wolfson292/pool_controller_v2/README.md

# pool_controller_v2
ESPHome Based Pool &amp; Spa Automation Controller
