wolfson292/pool_controller_v2/Pool-Spa-Controller-V2.kicad_pcb

## KiCad design Pool-Spa-Controller-V2.kicad_pcb (2025-02-10)

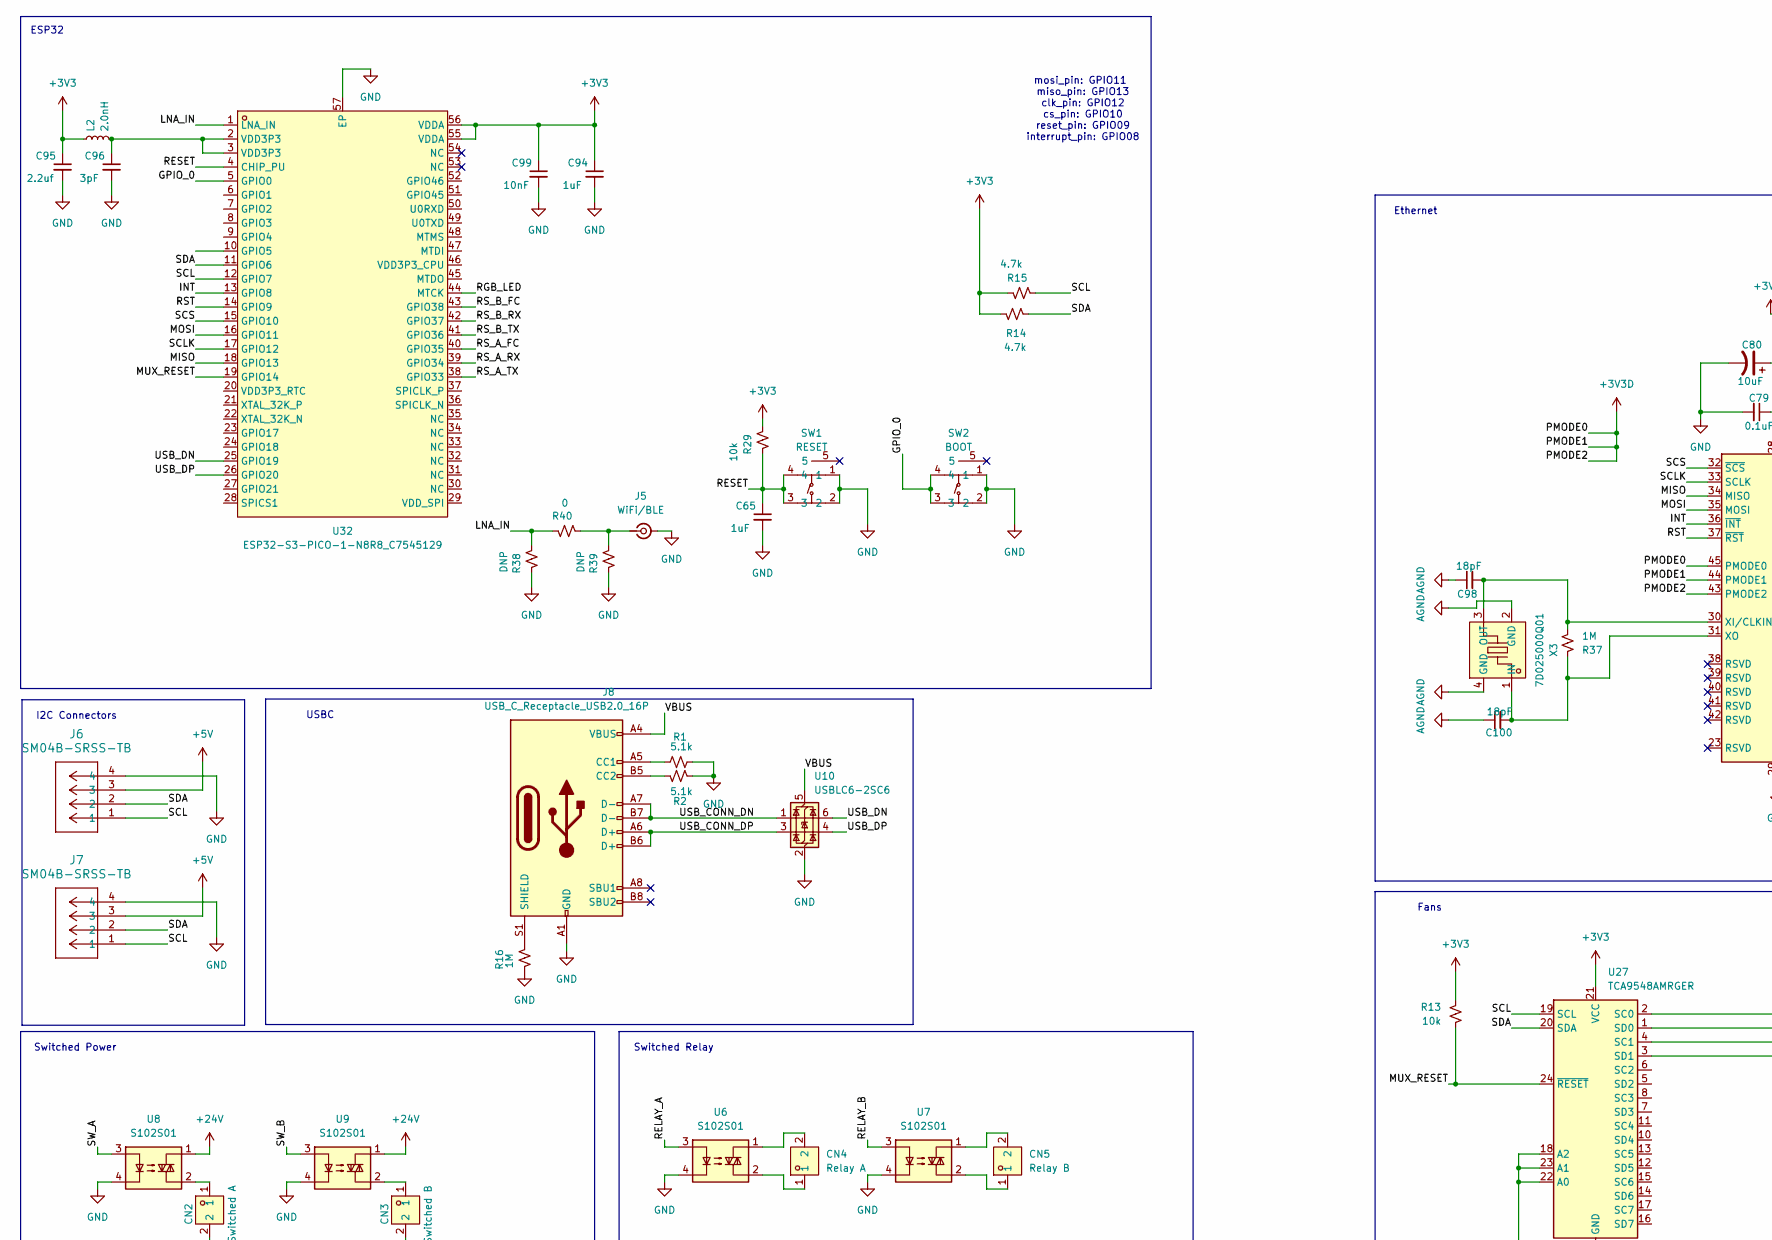
[picture p1: schematic Pool-Spa-Controller-V2.kicad_sch, part in row 1, column 1]

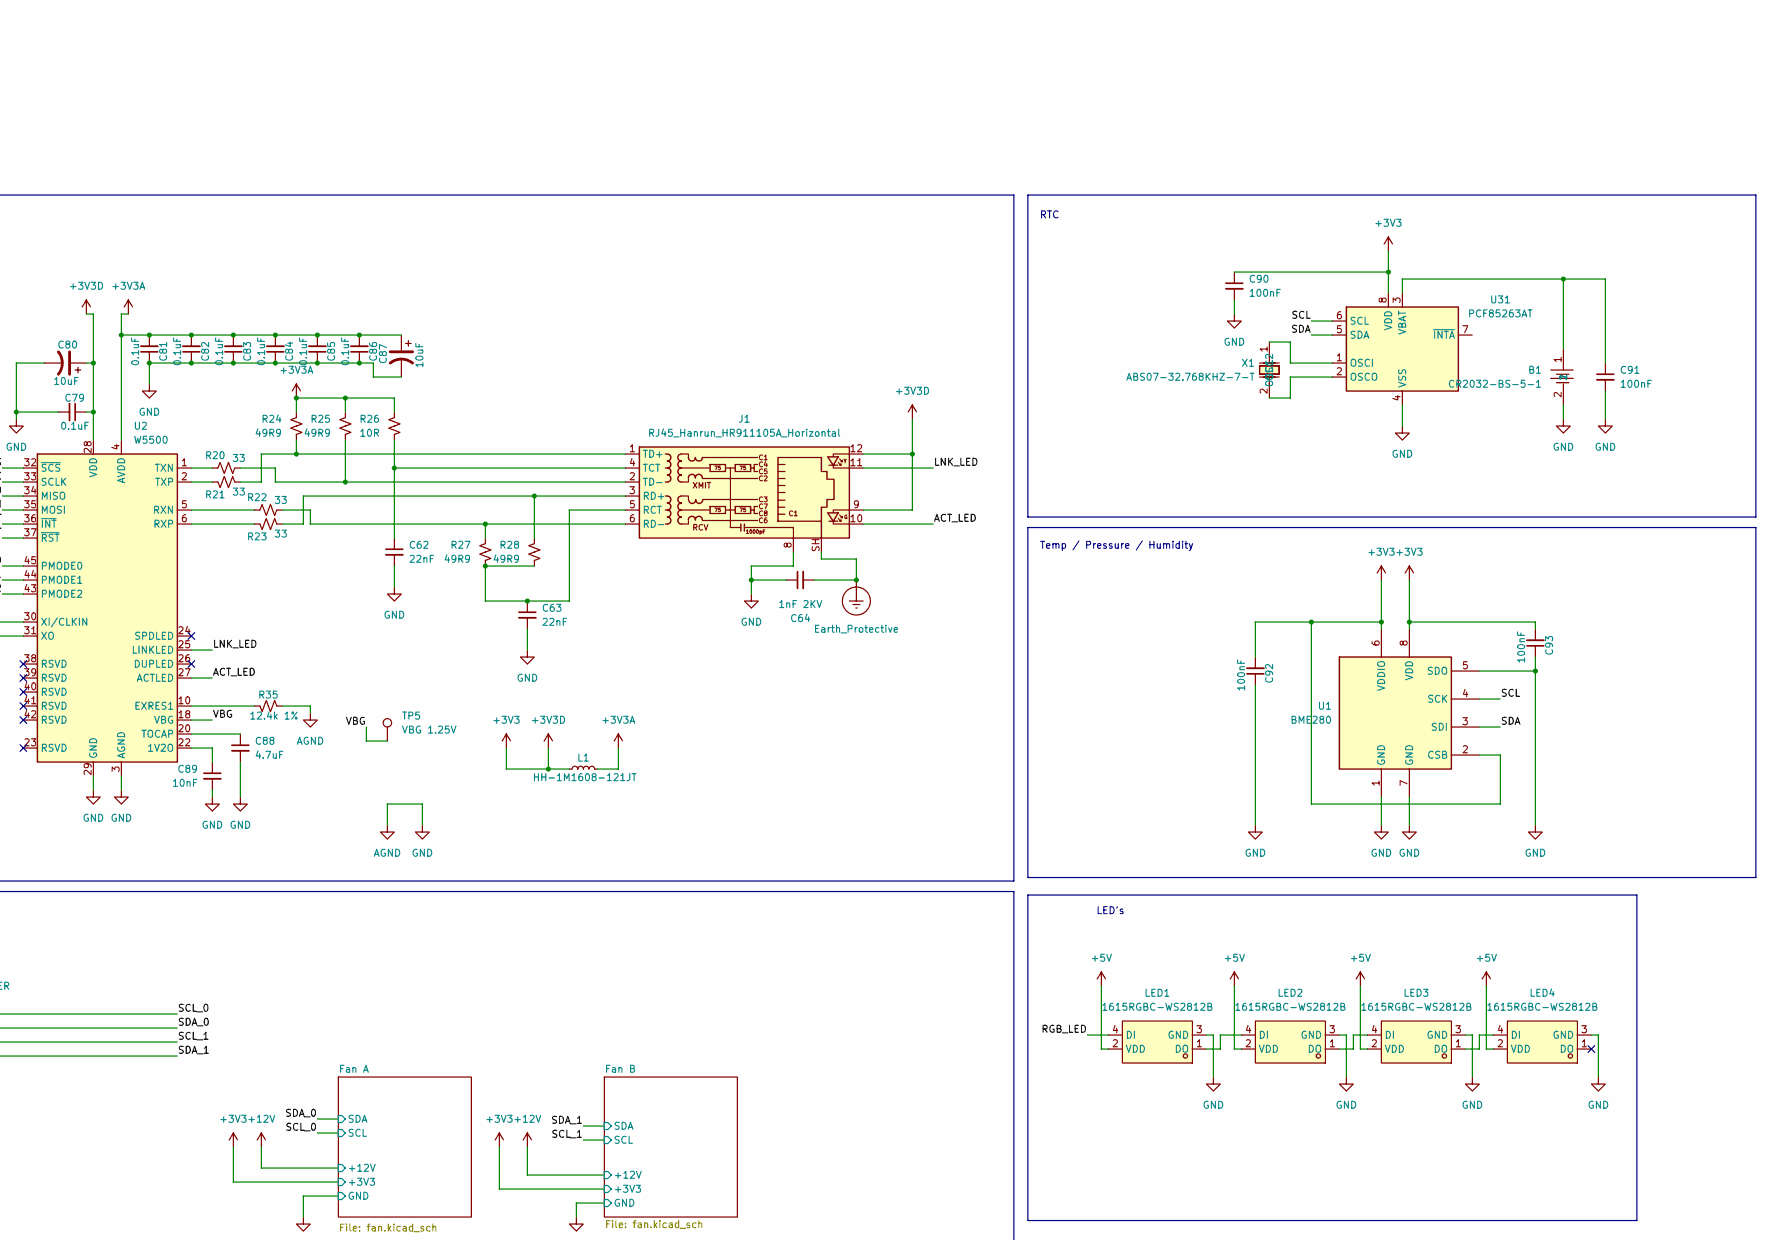
[picture p2: schematic Pool-Spa-Controller-V2.kicad_sch, part in row 1, column 2]

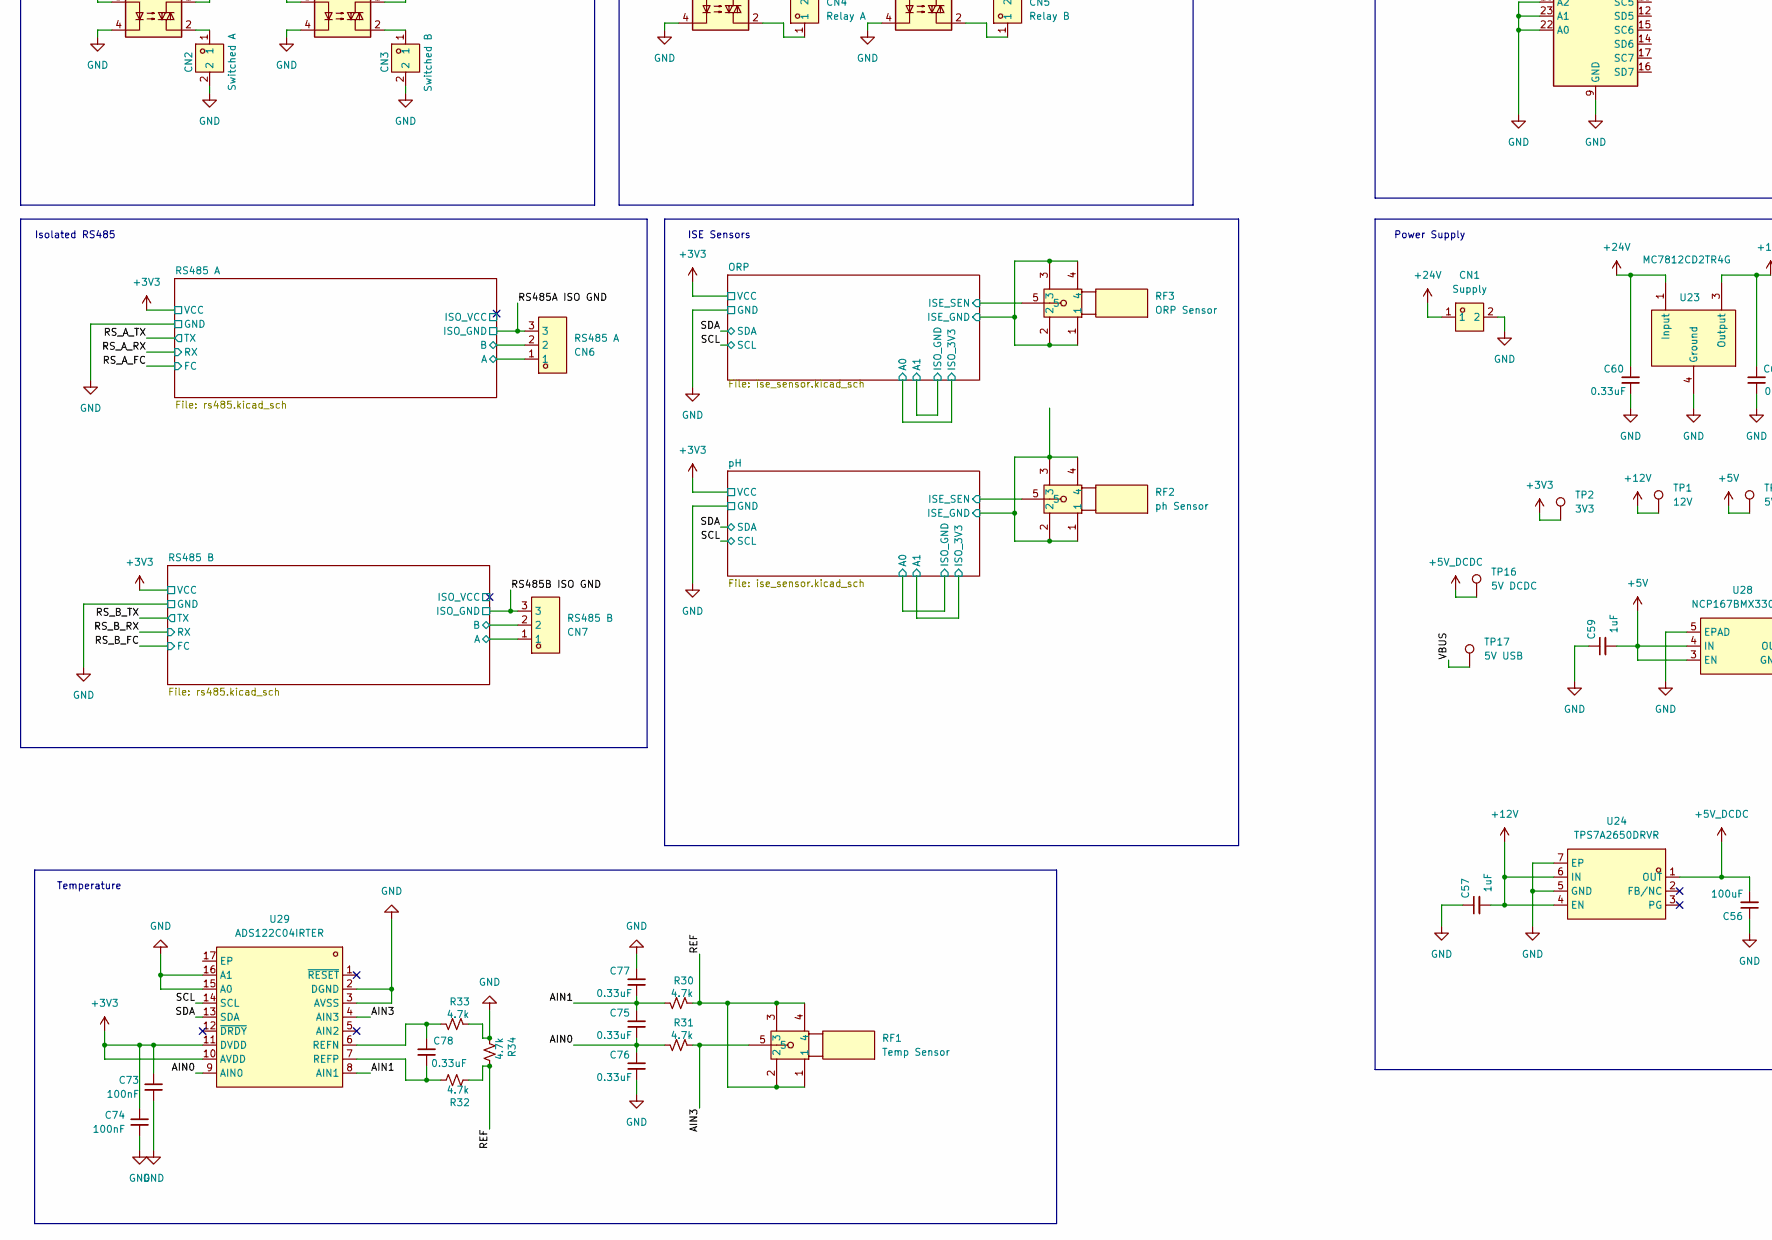
[picture p3: schematic Pool-Spa-Controller-V2.kicad_sch, part in row 2, column 1]

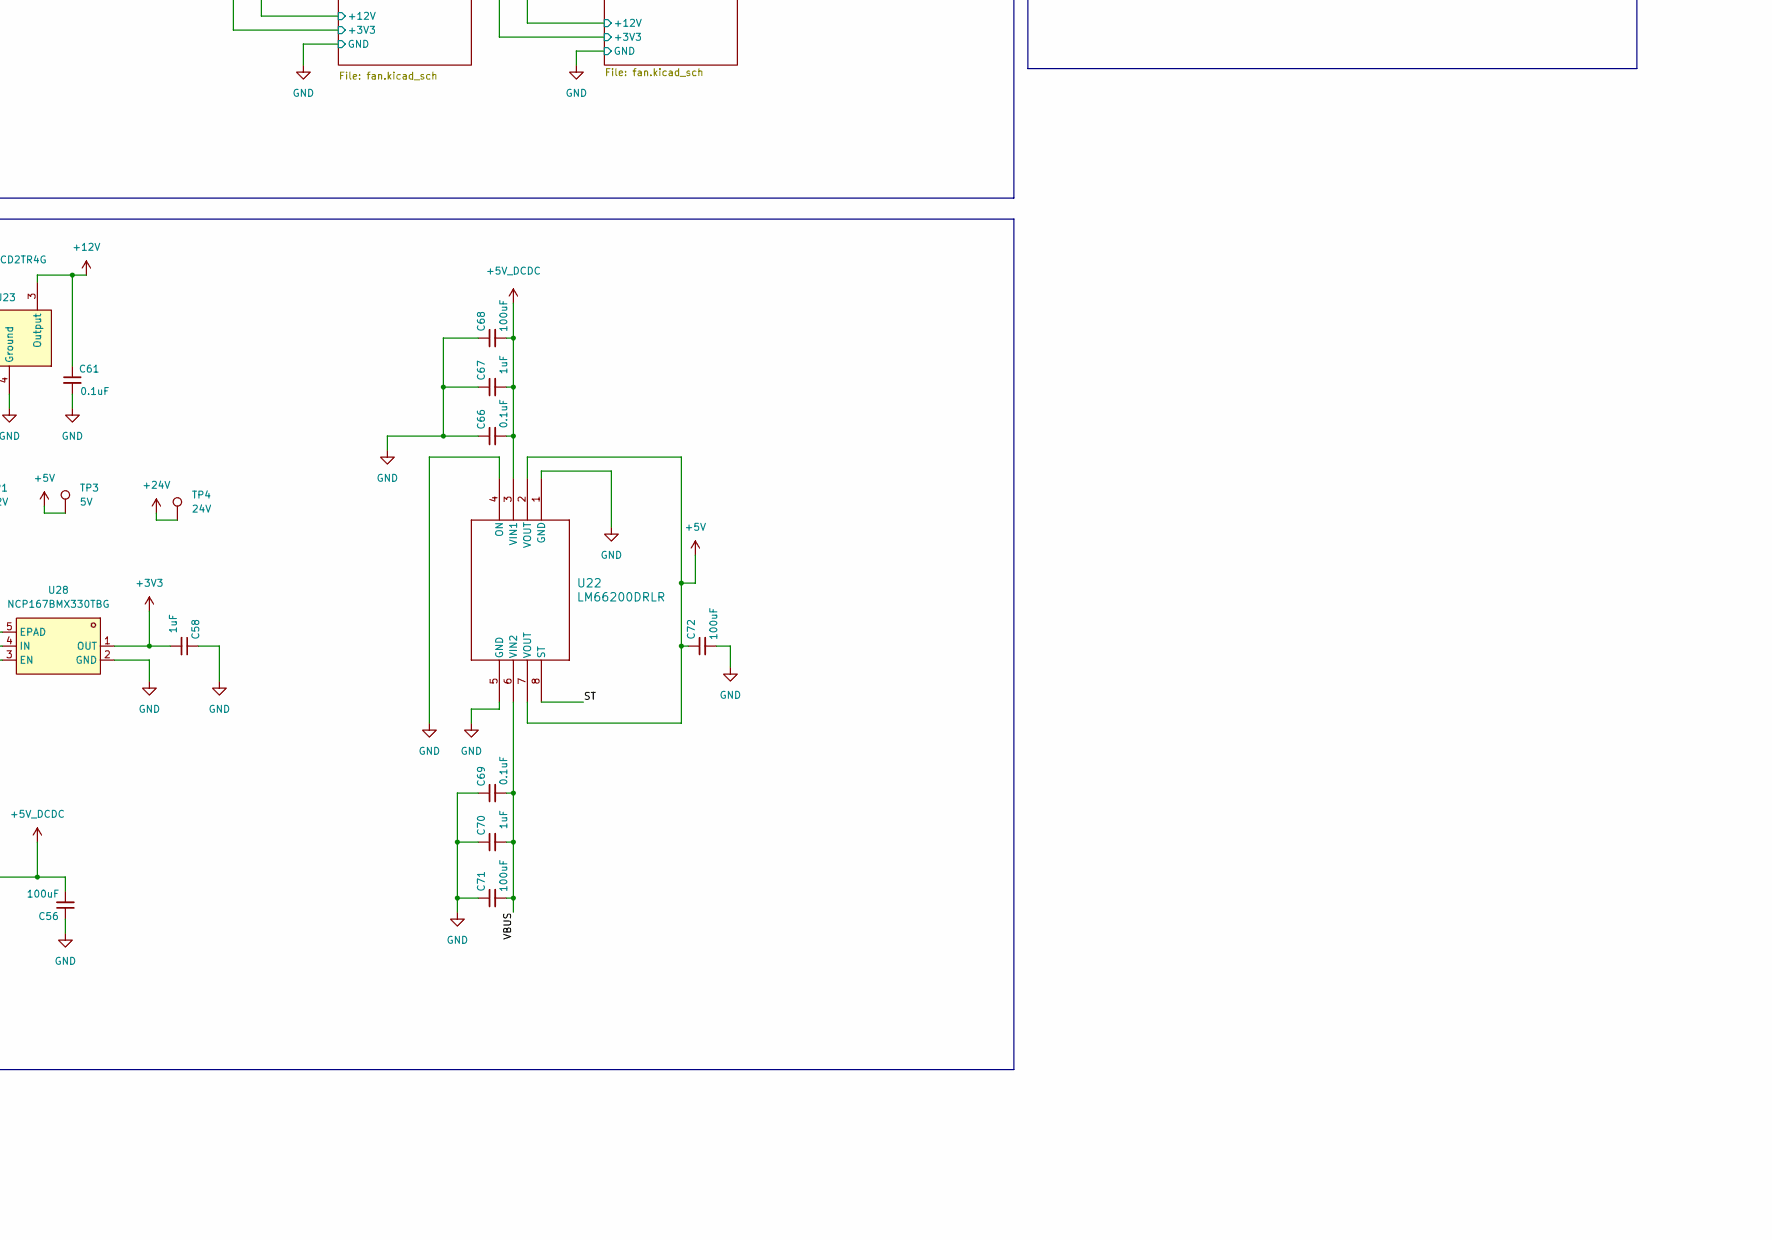
[picture p4: schematic Pool-Spa-Controller-V2.kicad_sch, part in row 2, column 2]

Parts:
B1: CR2032-BS-5-1; BAT-TH_CR2032-BS-5-1; LCSC Part C70379
C56, C68, C71, C72: 100uF; C_0402_1005Metric
C57, C58, C59, C65, C67, C70, C94: 1uF; C_0402_1005Metric
C60, C75, C76, C77, C78: 0.33uF; C_0402_1005Metric
C61, C66, C69, C79, C81, C82, C83, C84, C85, C86: 0.1uF; C_0402_1005Metric
C62, C63: 22nF; C_0402_1005Metric
C64: 1nF 2KV; C_0402_1005Metric
C73, C74: 100nF; C_0402_1005Metric; MPN 100nF 0201
C80, C87: 10uF; CP_EIA-1608-08_AVX-J
C88: 4.7uF; C_0402_1005Metric
C89, C99: 10nF; C_0402_1005Metric
C90, C91, C92, C93: 100nF; C_0402_1005Metric
C95: 2.2uf; C_0402_1005Metric
C96: 3pF; C_0402_1005Metric
C98, C100: 18pF; C_0402_1005Metric
CN1: Supply; CONN-TH_2P-P2.54_1725656; LCSC Part C3029316
CN2: Switched A; CONN-TH_2P-P2.54_1725656; LCSC Part C3029316
CN3: Switched B; CONN-TH_2P-P2.54_1725656; LCSC Part C3029316
CN4: Relay A; CONN-TH_2P-P2.54_1725656; LCSC Part C3029316
CN5: Relay B; CONN-TH_2P-P2.54_1725656; LCSC Part C3029316
CN6: RS485 A; CONN-TH_3P-P2.54_1725669; LCSC Part C5288763
CN7: RS485 B; CONN-TH_3P-P2.54_1725669; LCSC Part C5288763
J1: RJ45_Hanrun_HR911105A_Horizontal
J5: WiFi/BLE; U.FL_Molex_MCRF_73412-0110_Vertical
J6, J7: SM04B-SRSS-TB; CONN_SM04B-SRSS-TB_JST
J8: USB_C_Receptacle_USB2.0_16P; USB_C_Receptacle_G-Switch_GT-USB-7010ASV
L1: HH-1M1608-121JT; L_0603_1608Metric
L2: 2.0nH; L_0402_1005Metric
LED1, LED2, LED3, LED4: 1615RGBC-WS2812B; LED-SMD_4P-L1.6-W1.5_XL-1615RGBC-WS2812B; LCSC Part C5349954
R1, R2: 5.1k; R_0402_1005Metric
R13: 10k; R_0402_1005Metric
R14, R15: 4.7k; R_0402_1005Metric; MPN 4.7k 0201
R16, R37: 1M; R_0402_1005Metric
R20, R21, R22, R23: 33; R_0402_1005Metric
R24, R25, R27, R28: 49R9; R_0402_1005Metric
R26: 10R; R_0402_1005Metric
R29: 10k; R_0402_1005Metric; MPN 4.7k 0201
R30, R31, R32, R33, R34: 4.7k; R_0402_1005Metric
R35: 12.4k 1%; R_0402_1005Metric
R38, R39: DNP; R_0402_1005Metric; MPN 4.7k 0201
R40: 0; R_0402_1005Metric; MPN 4.7k 0201
RF1: Temp Sensor; BNC-TH_DOSIN-801-0051; LCSC Part C521210
RF2: ph Sensor; BNC-TH_DOSIN-801-0051; LCSC Part C521210
RF3: ORP Sensor; BNC-TH_DOSIN-801-0051; LCSC Part C521210
SW1: RESET; SW-SMD_5P-L4.2-W2.8-P1.60-LS4.6-TR; LCSC Part C221678
SW2: BOOT; SW-SMD_5P-L4.2-W2.8-P1.60-LS4.6-TR; LCSC Part C221678
TP1: 12V; TestPoint_Pad_D1.0mm
TP2: 3V3; TestPoint_Pad_D1.0mm
TP3: 5V; TestPoint_Pad_D1.0mm
TP4: 24V; TestPoint_Pad_D1.0mm
TP5: VBG 1.25V; TestPoint_Pad_D1.0mm
TP16: 5V DCDC; TestPoint_Pad_D1.0mm
TP17: 5V USB; TestPoint_Pad_D1.0mm
U1: BME280; Bosch_LGA-8_2.5x2.5mm_P0.65mm_ClockwisePinNumbering
U2: W5500; LQFP-48_7x7mm_P0.5mm
U6, U7, U8, U9: S102S01; SIP4_Sharp-SSR_P7.62mm_Straight
U10: USBLC6-2SC6; SOT-23-6
U22: LM66200DRLR; SOT-5X3_DRL_TEX
U23: MC7812CD2TR4G; TO-263-2_L10.0-W9.1-P5.08-LS15.2-TL; LCSC Part C38744
U24: TPS7A2650DRVR; WSON-6_L2.0-W2.0-P0.65-TL-EP; LCSC Part C2866192
U27: TCA9548AMRGER; Texas_RGE0024C_VQFN-24-1EP_4x4mm_P0.5mm_EP2.1x2.1mm
U28: NCP167BMX330TBG; XDFN-4_L1.0-W1.0-P0.65-BL-EP; LCSC Part C892227
U29: ADS122C04IRTER; WQFN-16_L3.0-W3.0-P0.50-TL-EP0.8; LCSC Part C2670105
U31: PCF85263AT; SOIC-8_3.9x4.9mm_P1.27mm
U32: ESP32-S3-PICO-1-N8R8_C7545129; QFN-56_L7.0-W7.0-P0.40-TL-EP4.0; LCSC Part C7545129
X1: ABS07-32.768KHZ-7-T; OSC-SMD_L3.2-W1.5; LCSC Part C276424
X3: 7D025000Q01; CRYSTAL-SMD_4P-L2.0-W1.6-BL; LCSC Part C648942

Connections:
+3V3: C58.2, C73.1, C74.1, C79.1, C80.1, C90.1, C92.2, C93.2, C94.1, C95.1, C99.1, J1.9, J1.12, L1.1, L2.1, R13.1, R14.1, R15.2, R29.1, TP2.1, U1.2 (CSB), U1.6 (VDDIO), U1.8 (VDD), U2.28 (VDD), U2.43 (PMODE2), U2.44 (PMODE1), U2.45 (PMODE0), U27.21 (VCC), U28.1 (OUT), U29.10 (AVDD), U29.11 (DVDD), U31.8 (VDD), U32.55 (VDDA), U32.56 (VDDA); also elsewhere on the board
+3V3A: C81.2, C82.2, C83.2, C84.2, C85.2, C86.2, C87.1, L1.2, R24.1, R25.1, R26.1, U2.4 (AVDD), U2.8 (AVDD), U2.11 (AVDD), U2.15 (AVDD), U2.17 (AVDD), U2.21 (AVDD)
+5V: C59.2, C72.1, J6.3, J7.3, LED1.2 (VDD), LED2.2 (VDD), LED3.2 (VDD), LED4.2 (VDD), TP3.1, U22.2 (VOUT), U22.7 (VOUT), U28.3 (EN), U28.4 (IN)
+5V_DCDC: C56.2, C66.2, C67.2, C68.2, TP16.1, U22.3 (VIN1), U24.1 (OUT)
+12V: C57.2, C61.1, TP1.1, U23.3 (Output), U24.4 (EN), U24.6 (IN); also elsewhere on the board
+24V: C60.1, CN1.1, TP4.1, U8.1, U9.1, U23.1 (Input)
/ACT_LED: J1.10, U2.27 (ACTLED)
/AIN0: C75.2, C76.1, R31.2, U29.9 (AIN0)
/AIN1: C75.1, C77.2, R30.2, U29.8 (AIN1)
/AIN3: R31.1, RF1.5, U29.4 (AIN3)
/GPIO_0: SW2.3, SW2.4, U32.5 (GPIO0)
/INT: U2.36 (~INT), U32.13 (GPIO8)
/LNA_IN: R38.1, R40.2, U32.1 (LNA_IN)
/LNK_LED: J1.11, U2.25 (LINKLED)
/MISO: U2.34 (MISO), U32.18 (GPIO13)
/MOSI: U2.35 (MOSI), U32.16 (GPIO11)
/MUX_RESET: R13.2, U27.24 (~RESET), U32.19 (GPIO14)
/ORP/ISE_SEN: RF3.5; also elsewhere on the board
/ORP/ISO_GND: RF3.1, RF3.2, RF3.3, RF3.4; also elsewhere on the board
/REF: R30.1, R32.1, R34.2, RF1.1, RF1.2, RF1.3, RF1.4
/RELAY_A: U6.3
/RELAY_B: U7.3
/RESET: C65.1, R29.2, SW1.3, SW1.4, U32.4 (CHIP_PU)
/RGB_LED: LED1.4 (DI), U32.44 (MTCK)
/RS485 A/A: CN6.1; also elsewhere on the board
/RS485 A/B: CN6.2; also elsewhere on the board
/RS485 B/A: CN7.1; also elsewhere on the board
/RS485 B/B: CN7.2; also elsewhere on the board
/RS485A ISO GND: CN6.3; also elsewhere on the board
/RS485B ISO GND: CN7.3; also elsewhere on the board
/RST: U2.37 (~RST), U32.14 (GPIO9)
/RS_A_FC: U32.40 (GPIO35); also elsewhere on the board
/RS_A_RX: U32.39 (GPIO34); also elsewhere on the board
/RS_A_TX: U32.38 (GPIO33); also elsewhere on the board
/RS_B_FC: U32.43 (GPIO38); also elsewhere on the board
/RS_B_RX: U32.42 (GPIO37); also elsewhere on the board
/RS_B_TX: U32.41 (GPIO36); also elsewhere on the board
/SCL: J6.1, J7.1, R15.1, U1.4 (SCK), U27.19 (SCL), U29.14 (SCL), U31.6 (SCL), U32.12 (GPIO7); also elsewhere on the board
/SCLK: U2.33 (SCLK), U32.17 (GPIO12)
/SCL_0: U27.2 (SC0); also elsewhere on the board
/SCL_1: U27.4 (SC1); also elsewhere on the board
/SCS: U2.32 (~SCS), U32.15 (GPIO10)
/SDA: J6.2, J7.2, R14.2, U1.3 (SDI), U27.20 (SDA), U29.13 (SDA), U31.5 (SDA), U32.11 (GPIO6); also elsewhere on the board
/SDA_0: U27.1 (SD0); also elsewhere on the board
/SDA_1: U27.3 (SD1); also elsewhere on the board
/ST: U22.8 (ST)
/SW_A: U8.3
/SW_B: U9.3
/USB_CONN_DN: J8.A7 (D-), J8.B7 (D-), U10.1 (I/O1)
/USB_CONN_DP: J8.A6 (D+), J8.B6 (D+), U10.3 (I/O2)
/USB_DN: U10.6 (I/O1), U32.25 (GPIO19)
/USB_DP: U10.4 (I/O2), U32.26 (GPIO20)
/VBG: TP5.1, U2.18 (VBG)
/VBUS: C69.2, C70.2, C71.2, J8.A4 (VBUS), J8.A9 (VBUS), J8.B4 (VBUS), J8.B9 (VBUS), TP17.1, U10.5 (VBUS), U22.6 (VIN2)
/pH/ISE_SEN: RF2.5; also elsewhere on the board
/pH/ISO_GND: RF2.1, RF2.2, RF2.3, RF2.4; also elsewhere on the board
AGND: B1.2, C56.1, C57.1, C58.1, C59.1, C60.2, C61.2, C62.2, C63.2, C64.1, C65.2, C66.1, C67.1, C68.1, C69.1, C70.1, C71.1, C72.2, C73.2, C74.2, C76.2, C77.1, C79.2, C80.2, C81.1, C82.1, C83.1, C84.1, C85.1, C86.1, C87.2, C88.2, C89.2, C90.2, C91.2, C92.1, C93.1, C94.2, C95.2, C96.2, C98.1, C99.2, C100.1, CN1.2, CN2.2, CN3.2, J1.8, J5.2 (Ext), J6.4, J7.4, J8.A1 (GND), J8.A12 (GND), J8.B1 (GND), J8.B12 (GND), LED1.3 (GND), LED2.3 (GND), LED3.3 (GND), LED4.3 (GND), R1.2, R2.2, R16.2, R33.1, R34.1, R35.2, R38.2, R39.2, SW1.1, SW1.2, SW2.1, SW2.2, U1.1 (GND), U1.5 (SDO), U1.7 (GND), U2.3 (AGND), U2.9 (AGND), U2.14 (AGND), U2.16 (AGND), U2.19 (AGND), U2.29 (GND), U2.48 (AGND), U6.4, U7.4, U8.4, U9.4, U10.2 (GND), U22.1 (GND), U22.4 (ON), U22.5 (GND), U23.4 (Ground), U24.5 (GND), U24.7 (EP), U27.9 (GND), U27.18 (A2), U27.22 (A0), U27.23 (A1), U28.2 (GND), U28.5 (EPAD), U29.2 (DGND), U29.3 (AVSS), U29.15 (A0), U29.16 (A1), U31.4 (VSS), U32.57 (EP), X3.2 (GND), X3.4 (GND); also elsewhere on the board
Earth_Protective: C64.2, J1.SH
unnamed: C96.1, L2.2, U32.2 (VDD3P3), U32.3 (VDD3P3)
unnamed: CN2.1, U8.2
unnamed: CN3.1, U9.2
unnamed: CN4.1, U6.2
unnamed: CN4.2, U6.1
unnamed: CN5.1, U7.2
unnamed: CN5.2, U7.1
unnamed: C63.1, J1.5 (RCT), R27.2, R28.2
unnamed: J1.3 (RD+), R23.2, R28.1
unnamed: J1.6 (RD-), R22.2, R27.1
unnamed: C62.1, J1.4 (TCT), R26.2
unnamed: J1.1 (TD+), R21.2, R24.2
unnamed: J1.2 (TD-), R20.2, R25.2
unnamed: J5.1 (In), R39.1, R40.1
unnamed: J8.A5 (CC1), R1.1
unnamed: J8.B5 (CC2), R2.1
unnamed: J8.S1 (SHIELD), R16.1
unnamed: LED1.1 (DO), LED2.4 (DI)
unnamed: LED2.1 (DO), LED3.4 (DI)
unnamed: LED3.1 (DO), LED4.4 (DI)
unnamed: C89.1, U2.22 (1V2O)
unnamed: R35.1, U2.10 (EXRES1)
unnamed: R22.1, U2.5 (RXN)
unnamed: R23.1, U2.6 (RXP)
unnamed: C88.1, U2.20 (TOCAP)
unnamed: R20.1, U2.1 (TXN)
unnamed: R21.1, U2.2 (TXP)
unnamed: C98.2, R37.2, U2.30 (XI/CLKIN), X3.3 (OUT)
unnamed: C100.2, R37.1, U2.31 (XO), X3.1 (IN)
unnamed: C78.1, R33.2, U29.6 (REFN)
unnamed: C78.2, R32.2, U29.7 (REFP)
unnamed: U31.1 (OSCI), X1.1 (OSC1)
unnamed: U31.2 (OSCO), X1.2 (OSC2)
unnamed: B1.1, C91.1, U31.3 (VBAT)

Notes on the sheet:
Switched Power
Switched Relay
ISE Sensors
Temperature
mosi_pin: GPIO11 miso_pin: GPIO13 clk_pin: GPIO12 cs_pin: GPIO10 reset_pin: GPIO09 interrupt_pin: GPIO08
I2C Connectors
LED's
USBC
Ethernet
Power Supply
RTC
ESP32
Temp / Pressure / Humidity
Isolated RS485
Fans

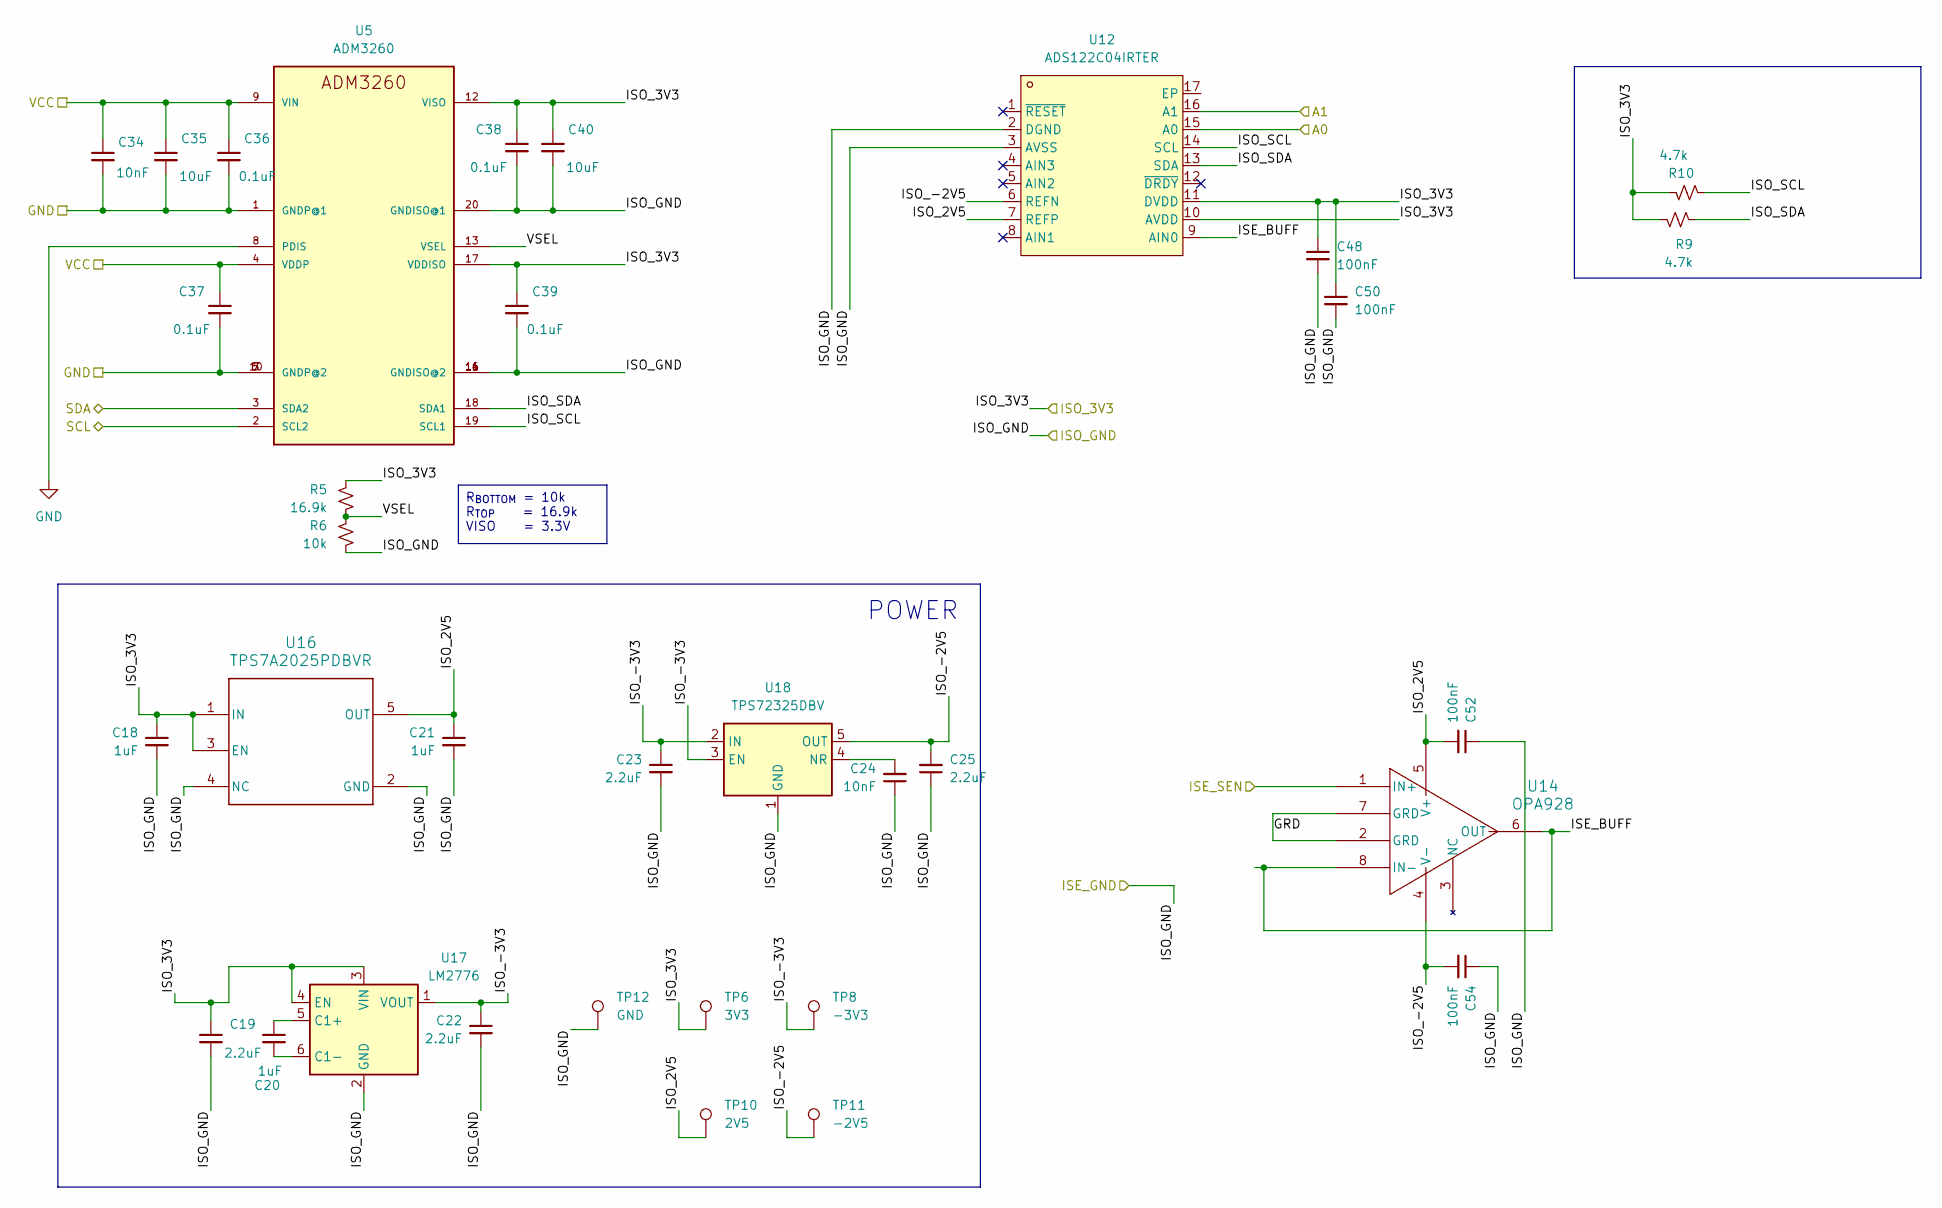
[picture p5: schematic ise_sensor.kicad_sch]

Parts:
C18, C20, C21: 1uF; C_0402_1005Metric; MPN 1uF 0201
C19, C22: 2.2uF; C_0402_1005Metric; MPN 1uF 0201
C23, C25: 2.2uF; C_0402_1005Metric; MPN 2.2uF 0201
C24, C34: 10nF; C_0402_1005Metric; MPN 10nF 0201
C35, C40: 10uF; C_0402_1005Metric; MPN 10uF 0201
C36, C37, C38, C39: 0.1uF; C_0402_1005Metric; MPN 0.1uF 0201
C48, C50: 100nF; C_0402_1005Metric; MPN 100nF 0201
C52, C54: 100nF; C_0402_1005Metric
R5: 16.9k; R_0402_1005Metric; MPN 30.9k 0201
R6: 10k; R_0402_1005Metric; MPN 10k 0201
R9, R10: 4.7k; R_0402_1005Metric; MPN 4.7k 0201
TP6: 3V3; TestPoint_Pad_D1.0mm
TP8: -3V3; TestPoint_Pad_D1.0mm
TP10: 2V5; TestPoint_Pad_D1.0mm
TP11: -2V5; TestPoint_Pad_D1.0mm
TP12: GND; TestPoint_Pad_D1.0mm
U5: ADM3260; ADM3260_SOP65P780X200-20N
U12: ADS122C04IRTER; WQFN-16_L3.0-W3.0-P0.50-TL-EP0.8; LCSC Part C2670105
U14: OPA928; SOIC8_D_TEX
U16: TPS7A2025PDBVR; DBV0005A-IPC_A
U17: LM2776; SOT-23-6
U18: TPS72325DBV; SOT-23-5

Connections:
+3V3: C34.1, C35.1, C36.1, C37.1, U5.4 (VDDP), U5.9 (VIN); also elsewhere on the board
/ORP/GRD: U14.2 (GRD), U14.7 (GRD)
/ORP/ISE_BUFF: U12.9 (AIN0), U14.6 (OUT), U14.8 (IN-)
/ORP/ISE_SEN: U14.1 (IN+); also elsewhere on the board
/ORP/ISO_2V5: C21.1, C52.2, TP10.1, U12.7 (REFP), U14.5 (V+), U16.5 (OUT)
/ORP/ISO_3V3: C18.1, C19.1, C38.1, C39.1, C40.1, C48.1, C50.1, R5.2, R9.1, R10.2, TP6.1, U5.12 (VISO), U5.17 (VDDISO), U12.10 (AVDD), U12.11 (DVDD), U12.15 (A0), U16.1 (IN), U16.3 (EN), U17.3 (VIN), U17.4 (EN)
/ORP/ISO_-2V5: C25.2, C54.2, TP11.1, U12.6 (REFN), U14.4 (V-), U18.5 (OUT)
/ORP/ISO_-3V3: C22.1, C23.1, TP8.1, U17.1 (VOUT), U18.2 (IN), U18.3 (EN)
/ORP/ISO_GND: C18.2, C19.2, C21.2, C22.2, C23.2, C24.1, C25.1, C38.2, C39.2, C40.2, C48.2, C50.2, C52.1, C54.1, R6.2, TP12.1, U5.11 (GNDISO@2), U5.14 (GNDISO@2), U5.16 (GNDISO@2), U5.20 (GNDISO@1), U12.2 (DGND), U12.3 (AVSS), U12.16 (A1), U16.2 (GND), U16.4 (NC), U17.2 (GND), U18.1 (GND); also elsewhere on the board
/ORP/ISO_SCL: R10.1, U5.19 (SCL1), U12.14 (SCL)
/ORP/ISO_SDA: R9.2, U5.18 (SDA1), U12.13 (SDA)
/ORP/VSEL: R5.1, R6.1, U5.13 (VSEL)
/SCL: U5.2 (SCL2); also elsewhere on the board
/SDA: U5.3 (SDA2); also elsewhere on the board
AGND: C34.2, C35.2, C36.2, C37.2, U5.1 (GNDP@1), U5.5 (GNDP@2), U5.7 (GNDP@2), U5.8 (PDIS), U5.10 (GNDP@2); also elsewhere on the board
unnamed: C20.1, U17.5 (C1+)
unnamed: C20.2, U17.6 (C1-)
unnamed: C24.2, U18.4 (NR)

Parts of its further copies:
C26, C28, C29: 1uF; C_0402_1005Metric; MPN 1uF 0201
C27, C30: 2.2uF; C_0402_1005Metric; MPN 1uF 0201
C31, C33: 2.2uF; C_0402_1005Metric; MPN 2.2uF 0201
C32, C41: 10nF; C_0402_1005Metric; MPN 10nF 0201
C42, C47: 10uF; C_0402_1005Metric; MPN 10uF 0201
C43, C44, C45, C46: 0.1uF; C_0402_1005Metric; MPN 0.1uF 0201
C49, C51: 100nF; C_0402_1005Metric; MPN 100nF 0201
C53, C55: 100nF; C_0402_1005Metric
R7: 16.9k; R_0402_1005Metric; MPN 30.9k 0201
R8: 10k; R_0402_1005Metric; MPN 10k 0201
R11, R12: 4.7k; R_0402_1005Metric; MPN 4.7k 0201
TP7: 3V3; TestPoint_Pad_D1.0mm
TP9: -3V3; TestPoint_Pad_D1.0mm
TP13: GND; TestPoint_Pad_D1.0mm
TP14: 2V5; TestPoint_Pad_D1.0mm
TP15: -2V5; TestPoint_Pad_D1.0mm
U11: ADM3260; ADM3260_SOP65P780X200-20N
U13: ADS122C04IRTER; WQFN-16_L3.0-W3.0-P0.50-TL-EP0.8; LCSC Part C2670105
U15: OPA928; SOIC8_D_TEX
U19: TPS7A2025PDBVR; DBV0005A-IPC_A
U20: LM2776; SOT-23-6
U21: TPS72325DBV; SOT-23-5

Connections of its further copies:
+3V3: C41.1, C42.1, C43.1, C44.1, U11.4 (VDDP), U11.9 (VIN); also elsewhere on the board
/SCL: U11.2 (SCL2); also elsewhere on the board
/SDA: U11.3 (SDA2); also elsewhere on the board
/pH/GRD: U15.2 (GRD), U15.7 (GRD)
/pH/ISE_BUFF: U13.9 (AIN0), U15.6 (OUT), U15.8 (IN-)
/pH/ISE_SEN: U15.1 (IN+); also elsewhere on the board
/pH/ISO_2V5: C29.1, C53.2, TP14.1, U13.7 (REFP), U15.5 (V+), U19.5 (OUT)
/pH/ISO_3V3: C26.1, C27.1, C45.1, C46.1, C47.1, C49.1, C51.1, R7.2, R11.1, R12.2, TP7.1, U11.12 (VISO), U11.17 (VDDISO), U13.10 (AVDD), U13.11 (DVDD), U13.16 (A1), U19.1 (IN), U19.3 (EN), U20.3 (VIN), U20.4 (EN)
/pH/ISO_-2V5: C33.2, C55.2, TP15.1, U13.6 (REFN), U15.4 (V-), U21.5 (OUT)
/pH/ISO_-3V3: C30.1, C31.1, TP9.1, U20.1 (VOUT), U21.2 (IN), U21.3 (EN)
/pH/ISO_GND: C26.2, C27.2, C29.2, C30.2, C31.2, C32.1, C33.1, C45.2, C46.2, C47.2, C49.2, C51.2, C53.1, C55.1, R8.2, TP13.1, U11.11 (GNDISO@2), U11.14 (GNDISO@2), U11.16 (GNDISO@2), U11.20 (GNDISO@1), U13.2 (DGND), U13.3 (AVSS), U13.15 (A0), U19.2 (GND), U19.4 (NC), U20.2 (GND), U21.1 (GND); also elsewhere on the board
/pH/ISO_SCL: R12.1, U11.19 (SCL1), U13.14 (SCL)
/pH/ISO_SDA: R11.2, U11.18 (SDA1), U13.13 (SDA)
/pH/VSEL: R7.1, R8.1, U11.13 (VSEL)
AGND: C41.2, C42.2, C43.2, C44.2, U11.1 (GNDP@1), U11.5 (GNDP@2), U11.7 (GNDP@2), U11.8 (PDIS), U11.10 (GNDP@2); also elsewhere on the board
unnamed: C28.1, U20.5 (C1+)
unnamed: C28.2, U20.6 (C1-)
unnamed: C32.2, U21.4 (NR)

Notes on the sheet:
POWER
R_{BOTTOM} = 10k R_{TOP} = 16.9k VISO = 3.3V

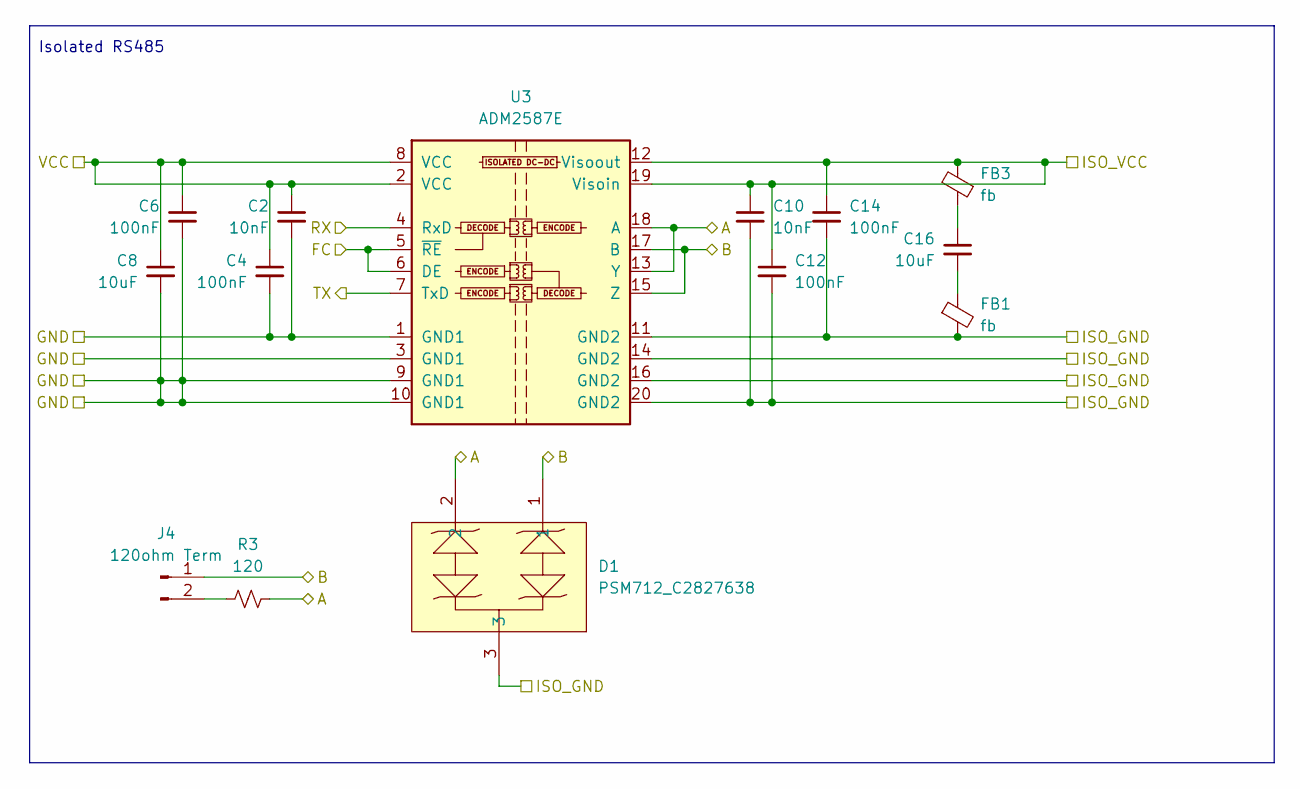
[picture p6: schematic rs485.kicad_sch]

Parts:
C2, C10: 10nF; C_0402_1005Metric
C4, C6, C12, C14: 100nF; C_0402_1005Metric
C8, C16: 10uF; C_0402_1005Metric
D1: PSM712_C2827638; SOT-23-3_L2.9-W1.3-P1.90-LS2.4-BL-2; LCSC Part C2827638
FB1, FB3: fb; L_0402_1005Metric
J4: 120ohm Term; PinHeader_1x02_P2.54mm_Vertical
R3: 120; R_0402_1005Metric
U3: ADM2587E; SOIC-20W_7.5x12.8mm_P1.27mm

Connections:
+3V3: C2.1, C4.1, C6.1, C8.1, U3.2 (VCC), U3.8 (VCC); also elsewhere on the board
/RS485 A/A: D1.2, R3.2, U3.13 (Y), U3.18 (A); also elsewhere on the board
/RS485 A/B: D1.1, J4.1, U3.15 (Z), U3.17 (B); also elsewhere on the board
/RS485 A/ISO_VCC: C10.1, C12.1, C14.1, FB3.2, U3.12 (Visoout), U3.19 (Visoin)
/RS485A ISO GND: C10.2, C12.2, C14.2, D1.3, FB1.2, U3.11 (GND2), U3.14 (GND2), U3.16 (GND2), U3.20 (GND2); also elsewhere on the board
/RS_A_FC: U3.5 (~RE), U3.6 (DE); also elsewhere on the board
/RS_A_RX: U3.4 (RxD); also elsewhere on the board
/RS_A_TX: U3.7 (TxD); also elsewhere on the board
AGND: C2.2, C4.2, C6.2, C8.2, U3.1 (GND1), U3.3 (GND1), U3.9 (GND1), U3.10 (GND1); also elsewhere on the board
unnamed: C16.1, FB3.1
unnamed: C16.2, FB1.1
unnamed: J4.2, R3.1

Parts of its further copies:
C3, C11: 10nF; C_0402_1005Metric
C5, C7, C13, C15: 100nF; C_0402_1005Metric
C9, C17: 10uF; C_0402_1005Metric
D2: PSM712_C2827638; SOT-23-3_L2.9-W1.3-P1.90-LS2.4-BL-2; LCSC Part C2827638
FB2, FB4: fb; L_0402_1005Metric
J9: 120ohm Term; PinHeader_1x02_P2.54mm_Vertical
R4: 120; R_0402_1005Metric
U4: ADM2587E; SOIC-20W_7.5x12.8mm_P1.27mm

Connections of its further copies:
+3V3: C3.1, C5.1, C7.1, C9.1, U4.2 (VCC), U4.8 (VCC); also elsewhere on the board
/RS485 B/A: D2.2, R4.2, U4.13 (Y), U4.18 (A); also elsewhere on the board
/RS485 B/B: D2.1, J9.1, U4.15 (Z), U4.17 (B); also elsewhere on the board
/RS485 B/ISO_VCC: C11.1, C13.1, C15.1, FB4.2, U4.12 (Visoout), U4.19 (Visoin)
/RS485B ISO GND: C11.2, C13.2, C15.2, D2.3, FB2.2, U4.11 (GND2), U4.14 (GND2), U4.16 (GND2), U4.20 (GND2); also elsewhere on the board
/RS_B_FC: U4.5 (~RE), U4.6 (DE); also elsewhere on the board
/RS_B_RX: U4.4 (RxD); also elsewhere on the board
/RS_B_TX: U4.7 (TxD); also elsewhere on the board
AGND: C3.2, C5.2, C7.2, C9.2, U4.1 (GND1), U4.3 (GND1), U4.9 (GND1), U4.10 (GND1); also elsewhere on the board
unnamed: C17.1, FB4.1
unnamed: C17.2, FB2.1
unnamed: J9.2, R4.1

Notes on the sheet:
Isolated RS485
