wolfson292/pool_controller_v2/Pool-Spa-Controller-V2.kicad_pcb

## KiCad design Pool-Spa-Controller-V2.kicad_pcb (continued)

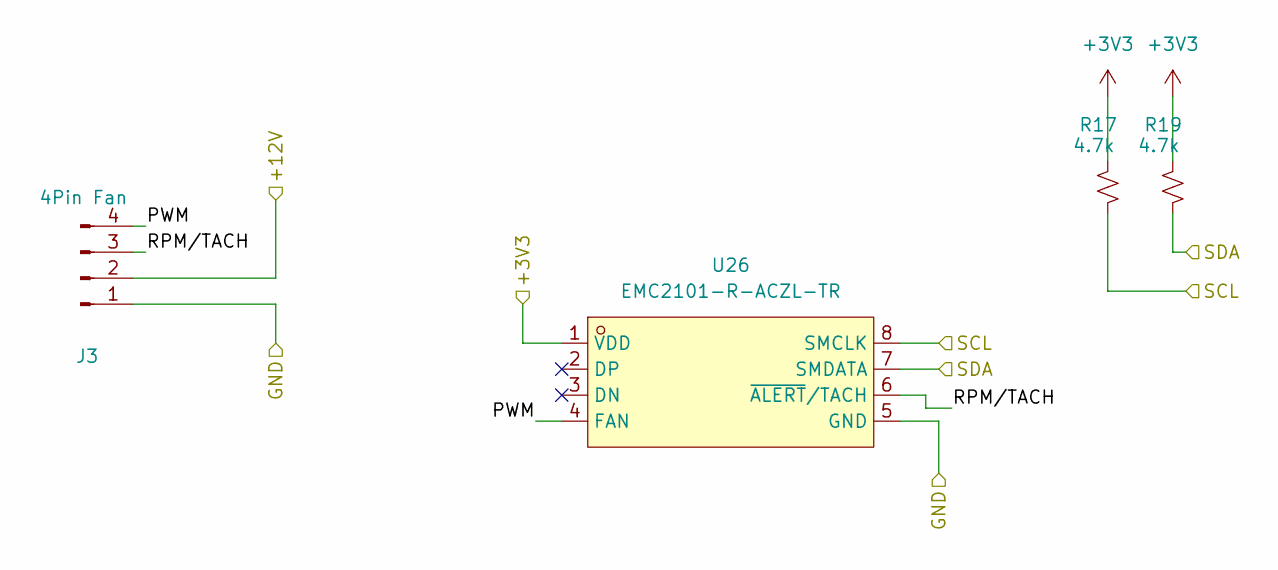
[picture p7: schematic fan.kicad_sch]

Parts:
J3: 4Pin Fan; PinHeader_1x04_P2.54mm_Vertical
R17, R19: 4.7k; R_0402_1005Metric
U26: EMC2101-R-ACZL-TR; MSOP-8_L3.0-W3.0-P0.65-LS4.9-BL; LCSC Part C626968

Connections:
+3V3: R17.1, R19.1, U26.1 (VDD); also elsewhere on the board
+12V: J3.2; also elsewhere on the board
/Fan B/PWM: J3.4, U26.4 (FAN)
/Fan B/RPM/TACH: J3.3, U26.6 (~ALERT/TACH)
/SCL_1: R17.2, U26.8 (SMCLK); also elsewhere on the board
/SDA_1: R19.2, U26.7 (SMDATA); also elsewhere on the board
AGND: J3.1, U26.5 (GND); also elsewhere on the board

Parts of its further copies:
J2: 4Pin Fan; PinHeader_1x04_P2.54mm_Vertical
R18, R36: 4.7k; R_0402_1005Metric
U25: EMC2101-R-ACZL-TR; MSOP-8_L3.0-W3.0-P0.65-LS4.9-BL; LCSC Part C626968

Connections of its further copies:
+3V3: R18.1, R36.1, U25.1 (VDD); also elsewhere on the board
+12V: J2.2; also elsewhere on the board
/Fan A/PWM: J2.4, U25.4 (FAN)
/Fan A/RPM/TACH: J2.3, U25.6 (~ALERT/TACH)
/SCL_0: R18.2, U25.8 (SMCLK); also elsewhere on the board
/SDA_0: R36.2, U25.7 (SMDATA); also elsewhere on the board
AGND: J2.1, U25.5 (GND); also elsewhere on the board

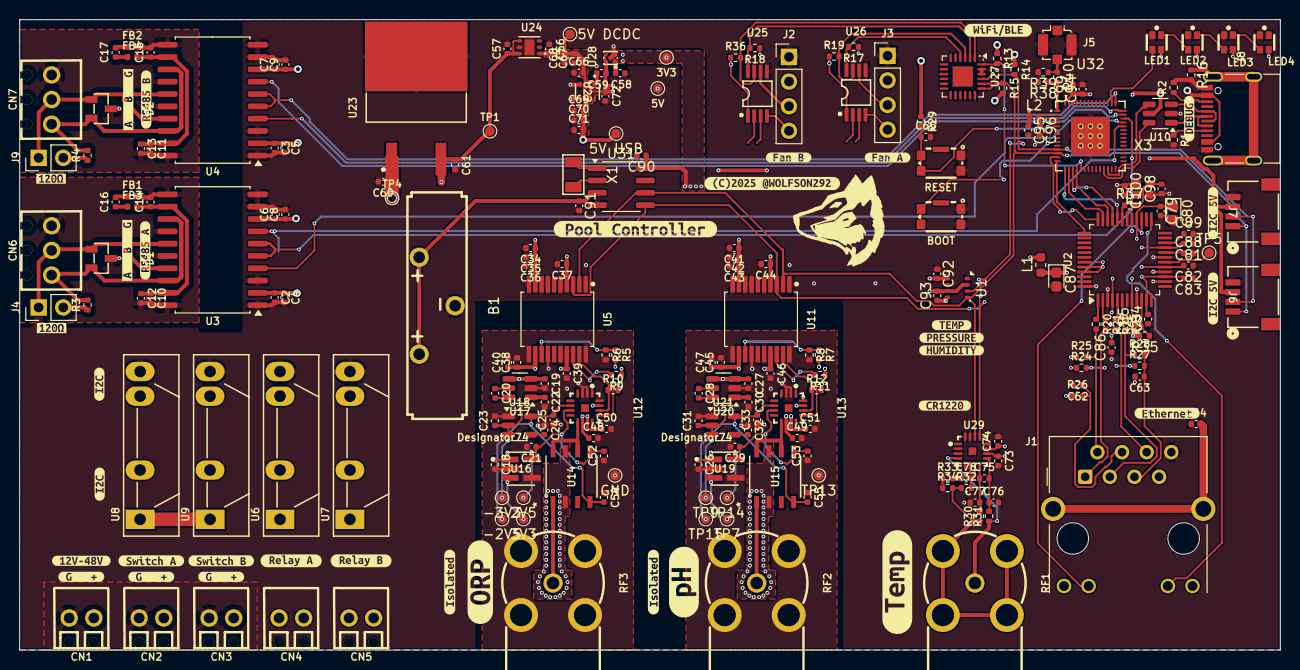
[picture p8: board Pool-Spa-Controller-V2.kicad_pcb from above]

Board: 4 copper layers, 130.0 x 65.0 mm, 256 parts (0 on the bottom side), 123 nets.

Other parts of the board:
kibuzzard-67A4FAF6: G***; kibuzzard-67A4FAF6
kibuzzard-67A62A6B: G***; kibuzzard-67A62A6B
kibuzzard-67A6282B: G***; kibuzzard-67A6282B
kibuzzard-67A6283A: G***; kibuzzard-67A6283A
kibuzzard-67A62823: G***; kibuzzard-67A62823
kibuzzard-67A62993: G***; kibuzzard-67A62993
kibuzzard-67AA2F78, kibuzzard-67AA2F78#2: G***; kibuzzard-67AA2F78
kibuzzard-679A47BC, kibuzzard-679A47BC#2: G***; kibuzzard-679A47BC
kibuzzard-67990E4A: G***; kibuzzard-67990E4A
kibuzzard-67990EC5: G***; kibuzzard-67990EC5
kibuzzard-67990EE4, kibuzzard-67990EE4#2: G***; kibuzzard-67990EE4
kibuzzard-67990FDB, kibuzzard-67990FDB#2, kibuzzard-67990FDB#3: G***; kibuzzard-67990FDB
kibuzzard-679907BF: G***; kibuzzard-679907BF
kibuzzard-679913F9: G***; kibuzzard-679913F9
kibuzzard-6799077F, kibuzzard-6799077F#2: G***; kibuzzard-6799077F
kibuzzard-6799095B: G***; kibuzzard-6799095B
kibuzzard-6799099B, kibuzzard-6799099B#2: G***; kibuzzard-6799099B
kibuzzard-6799101C: G***; kibuzzard-6799101C
kibuzzard-6799102D: G***; kibuzzard-6799102D
kibuzzard-6799136C: G***; kibuzzard-6799136C
kibuzzard-67990939: G***; kibuzzard-67990939
kibuzzard-67990953: G***; kibuzzard-67990953
kibuzzard-67991013: G***; kibuzzard-67991013
kibuzzard-67991024: G***; kibuzzard-67991024
kibuzzard-67991399: G***; kibuzzard-67991399
kibuzzard-67991402: G***; kibuzzard-67991402
kibuzzard-67991438: G***; kibuzzard-67991438
